fred2u/VMC-Controller/README.md

# VMC Controller

Wi‑Fi remote control for an **Orcon MVS‑15RH** ventilation unit (MVHR/extract fan, "VMC" in French), based on an ESP8266.

The original RF remote (Orcon 15RF) was taken apart: its keypad was replaced by an ESP8266 that "presses" the buttons instead. The ventilation unit can then be controlled from a smartphone (web page on the local network) and from Home Assistant, without touching the unit itself or the radio protocol.

> Personal project, meant for a private local network. The web interface has no password unless one is set at build time (`VMC_HTTP_PASSWORD`), and the traffic is plain HTTP either way: do not expose it to the Internet.

---

## Contents

1. [How it works](#how-it-works)
2. [Hardware](#hardware)
3. [Wiring](#wiring)
4. [Photos of the remote](#photos-of-the-remote)
5. [Final assembly](#final-assembly)
6. [Printed circuit board](#printed-circuit-board)
7. [Software](#software)
8. [Installation](#installation)
9. [Tests](#tests)
10. [Releases](#releases)
11. [Usage](#usage)
12. [HTTP API](#http-api)
13. [Home Assistant integration](#home-assistant-integration) (`rest_command` or MQTT)
14. [How the ventilation unit works](#how-the-ventilation-unit-works)
15. [Troubleshooting](#troubleshooting)
16. [Known limitations](#known-limitations)
17. [Ideas for improvement](#ideas-for-improvement)
18. [License](#license)

---

## How it works

```mermaid
flowchart LR
    phone["📱 Smartphone<br/>web browser"]
    ha["🏠 Home Assistant<br/>rest_command or MQTT"]
    usb["🔌 5 V USB charger"]

    subgraph box["3D-printed enclosure"]
        esp["ESP-Mx DevKit (ESP8285)<br/>web server + LittleFS"]
        remote["Orcon 15RF<br/>remote board<br/>without its keypad"]
    end

    vmc["🌀 Orcon MVS-15RH ventilation unit"]

    phone -- "HTTP, local Wi-Fi" --> esp
    ha -- "HTTP or MQTT, local Wi-Fi" --> esp
    usb -- "5 V" --> esp
    esp -- "6 GPIOs over FFC cable<br/>500 ms pulses" --> remote
    esp -. "3 V instead of the battery" .-> remote
    remote -- "RF radio" --> vmc
```

- The ESP8266 connects to the home Wi‑Fi and serves a small web page. Home Assistant drives it over HTTP (`rest_command`) or, optionally, MQTT.
- Each button on the page matches a button on the remote. The ESP pulls the matching output LOW for 500 ms, which simulates a press.
- The remote board then sends the radio command to the ventilation unit, as if the button had been pressed.
- The ESP powers the remote board from its 3 V output, instead of the battery. The ESP itself is powered by a USB charger.
- Everything fits in a 3D-printed enclosure.

## Hardware

| Item | Details |
|---|---|
| Ventilation unit | Orcon MVS‑15RH (single-flow extract ventilation, 4 positions + auto mode with humidity sensor) |
| Remote | Orcon 15RF, taken apart, keypad removed |
| Microcontroller | DOIT ESP‑Mx DevKit development board (ESP8285, an ESP8266 variant with built-in flash memory), PlatformIO environment `espmxdevkit` |
| Printed circuit board | Home-made 50 × 50 mm PCB that connects the ESP to the FFC breakout (see [Printed circuit board](#printed-circuit-board)) |
| Keypad link | 8-pin, 1.0 mm pitch flexible flat cable (FFC) and FFC breakout, instead of the keypad membrane |
| Power | 5 V USB charger to the ESP, ESP 3 V output to the remote board |
| Enclosure | 3D-printed |

### Bill of materials

Parts used in the build, checked against the [photos](#final-assembly) and the [PCB](#printed-circuit-board). The links are the listings the parts were bought from. Listings change or disappear, so check the specifications below rather than the listing title.

| Qty | Part | Specifications to check | Where to buy |
|---|---|---|---|
| 1 | Orcon 15RF remote | The remote paired with the ventilation unit, opened and keypad membrane removed | Existing remote |
| 1 | ESP8266 development board | DOIT ESP‑Mx DevKit: ESP‑M2 module (ESP8285), CH340 USB chip, micro‑USB, 2 rows of 12 pins, rows 25.4 mm apart. A NodeMCU board (2 rows of 15 pins) does not fit the PCB footprint. | [Amazon](https://www.amazon.fr/dp/B076Q77M1Z) |
| 1 | Flexible flat cable (FFC) | 8 pins, **1.0 mm pitch**, AWM 20624. It goes from the remote's keypad connector to the breakout. Check the length and whether the contacts are on the same side at both ends (type A) or on opposite sides (type B) against your own build. | [AliExpress](https://www.aliexpress.com/item/1005007561337665.html) |
| 1 | FFC breakout | 8-pin FPC adapter board with a **1.0 mm** flip-lock, bottom-contact connector soldered on, and straight 2.54 mm pins. The board silkscreen says `FPC-8P 0.5MM`: that is the unused pad row on the other side, the connector actually soldered is 1.0 mm. | [AliExpress](https://www.aliexpress.com/item/1005012643948143.html) (variant `Straight-8P`) |
| 1 | Home-made PCB | 50 × 50 mm, Gerber files in [`hardware/pcb/gerber/`](hardware/pcb/gerber/) | JLCPCB or another PCB maker |
| 1 | Power cable to the remote | Red and black wires from the ESP 3 V and GND to the battery holder, with a 2-pin detachable connector | Any |
| 1 | USB charger and micro‑USB cable | 5 V, any phone charger | Any |
| 1 | Enclosure | 3D-printed, STL files in [`hardware/enclosure/`](hardware/enclosure/) | 3D printer |

## Wiring

The original keypad is a flexible membrane with a ribbon that plugs into a connector on the remote board (see the [photos](#photos-of-the-remote) and the [final assembly](#final-assembly)). The membrane is removed and replaced by an FFC cable connected to the ESP through a breakout, which avoids soldering on the Orcon board.

Each ESP output is connected to one of the 6 button contacts of the keypad connector. At rest, the outputs are HIGH. A press is a 500 ms LOW state.

| Remote button | Function | Keypad contact | ESP8266 GPIO | Name in the code |
|---|---|---|---|---|
| 1 | Low position | 1 | GPIO2 | `PIN_LOW` |
| 2 | Medium position | 2 | GPIO15 | `PIN_MEDIUM` |
| 3 | High position | 3 | GPIO4 | `PIN_HIGH` |
| House | Default position | 4 | GPIO12 | `PIN_DEFAULT` |
| Auto | Automatic mode | 5 | GPIO5 | `PIN_AUTO` |
| Timer (clock) | Temporary high position | 6 | GPIO14 | `PIN_MAX` |
| Activity LED | On while a command is being sent | | GPIO16 | `PIN_LED` |

The contact numbers match the `// 1` to `// 6` comments in the code, and the 6 button contacts of the remote's keypad connector. On the ESP‑Mx DevKit and on the PCB, pins are labelled directly with their GPIO number (for example `D15` or `15` for GPIO15).

Power:

- 5 V USB charger to the ESP's USB input.
- ESP 3 V output and GND to the remote's battery holder (CR2032).

> GPIO2 and GPIO15 are also used to select the ESP8266 boot mode (GPIO2 must be HIGH and GPIO15 LOW at boot). If the ESP refuses to boot after a wiring change, check these two pins first.

## Photos of the remote

Orcon 15RF remote taken apart, before modification. The photos are in [`docs/photos/`](docs/photos/).

| | |
|---|---|
| Front | Open, with the battery |
| Front: House, Auto, Timer, 1, 2, 3 buttons | Open: CR2032 battery and label (VMN‑15LF01) |
| Keypad and frame | Board in its holder |
| Keypad and wall frame separated | Circuit board in its transparent holder |
| Keypad membrane | Board, component side |
| Keypad membrane: 6 contacts and its ribbon | Board, component side |
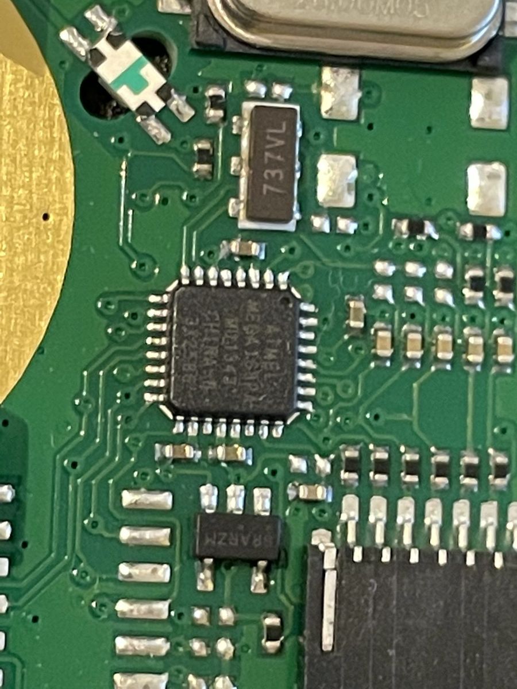
[picture p1: docs/photos/08-board-microcontroller.jpg]
Microcontroller
| Keypad connector |  |
| Keypad ribbon connector (on the left) | Close-up of the microcontroller |
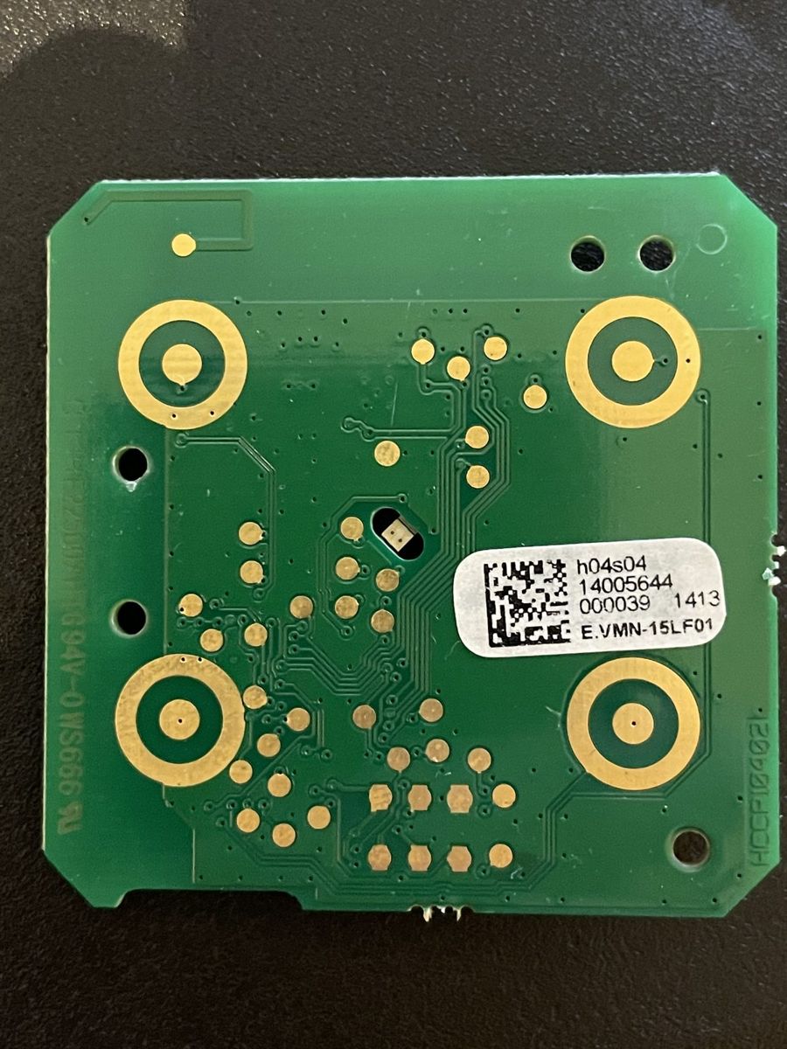
[picture p2: docs/photos/09-board-back.jpg]
Back of the board
|  | Parts of the build |
| Back of the board, contact pads | Parts of the build: ESP boards, FFC cables, 8-pin FFC breakout |

## Final assembly

| | |
|---|---|
| Assembly, open | Assembly in the enclosure |
| Remote board and ESP‑Mx DevKit, mounted on the home-made PCB. The FFC cable links the keypad connector to the 8-pin FFC breakout, and the red and black wires bring the ESP's 3 V to the battery holder, through a detachable connector. | ESP and FFC breakout in the enclosure, micro‑USB socket reachable from the side. |
| Enclosure closed | |
| 3D-printed enclosure, closed and powered over USB. The LED shows through the plastic. | |

### Enclosure files

The enclosure STL files are in [`hardware/enclosure/`](hardware/enclosure/). Dimensions read from the files, in mm:

| File | Dimensions (L × W × H) | Likely part |
|---|---|---|
| [`enclosure-bottom.stl`](hardware/enclosure/enclosure-bottom.stl) | 62 × 62 × 38 | Bottom of the enclosure |
| [`enclosure-lid.stl`](hardware/enclosure/enclosure-lid.stl) | 62 × 62 × 24 | Lid, which fits onto the bottom |
| [`board-plate.stl`](hardware/enclosure/board-plate.stl) | 53 × 53 × 1 | Plate that holds the boards |

GitHub shows a 3D preview of an STL file when you click on it.

## Printed circuit board

A small 50 × 50 mm PCB, designed in EasyEDA (April 2021) and made by JLCPCB, holds the ESP‑Mx DevKit and the FFC breakout. It replaces the loose wiring between the two.

| Top | Bottom (seen from below) |
|---|---|
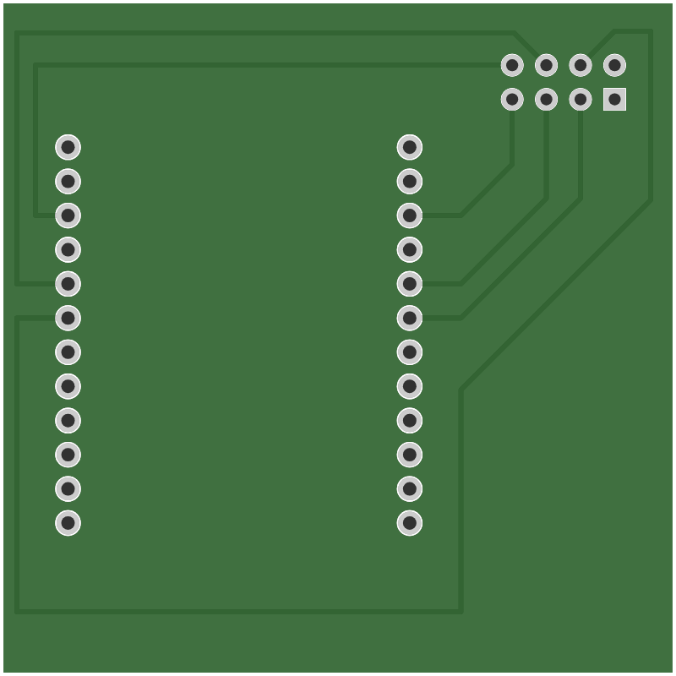
[picture p3: hardware/pcb/pcb-bottom.png]
PCB, bottom side
| PCB, top side |  |

- **Top side**: silkscreen of the ESP‑Mx DevKit footprint (2 rows of 12 pins) and of the `8P` connector (2 × 4 pins) that takes the FFC breakout.
- **Bottom side**: 6 traces connect the `8P` connector to GPIOs 2, 4, 5, 12, 14 and 15, that is the 6 buttons driven by the firmware.
- **Dimensions**: ESP rows 25.4 mm apart, 2.54 mm pitch, 1.0 mm holes for the ESP and 0.889 mm holes for the `8P` connector.

The Gerber files are in [`hardware/pcb/gerber/`](hardware/pcb/gerber/). They can be sent as they are to a manufacturer such as JLCPCB, once zipped.

> The manufactured PCB did not fit perfectly and the parts had to be forced in a little. Before ordering a new batch, measure the actual row spacing of your ESP board and the position of the connector, then fix the footprint if needed.

## Software

| | |
|---|---|
| Environment | [PlatformIO](https://platformio.org/) (VS Code extension recommended in `.vscode/extensions.json`) |
| Framework | Arduino for ESP8266 (`espressif8266`) |
| Web server | [ESPAsyncWebServer](https://github.com/ESP32Async/ESPAsyncWebServer) and [ESPAsyncTCP](https://github.com/ESP32Async/ESPAsyncTCP), maintained by ESP32Async, versions pinned in `platformio.ini` |
| Wi‑Fi setup | [ESPAsyncWiFiManager](https://github.com/alanswx/ESPAsyncWiFiManager) (captive portal on the same async web server) |
| Updates over Wi‑Fi | ArduinoOTA (included in the Arduino core), and an optional web update page |
| MQTT (optional) | [PubSubClient](https://github.com/knolleary/pubsubclient), with Home Assistant discovery |
| File system | LittleFS (web pages stored in flash) |
| Interface | Plain HTML, CSS and JavaScript, no framework (about 20 KB for both pages, light and dark themes) |

Layout:

```
├── platformio.ini       PlatformIO configuration (boards, libraries, LittleFS)
├── src/main.cpp         Firmware: Wi‑Fi, web server, GPIO control, OTA, MQTT
├── scripts/
│   ├── passwords.py     Reads the passwords and the MQTT settings from the VMC_* environment variables
│   ├── ota_auth.py      Gives that password to uploads over Wi‑Fi
│   └── version.py       Builds the version from the Git tags into the firmware
└── data/                Files uploaded to LittleFS
    ├── index.html       Remote control page
    ├── script.js        Sends commands, refreshes the mode, shows the board details
    ├── maintenance.html Maintenance page: pairing, remote reset, restart, Wi‑Fi
    ├── maintenance.js   Sends the maintenance actions, shows the ESP details
    └── style.css        Layout and light/dark themes (both pages)
test/                    Unit tests run on the computer (see Tests), with fake libraries in test/mocks/
docs/                    Photos of the build and screenshots of the interface
hardware/                Enclosure STL files and PCB Gerber files
.github/workflows/ci.yml Tests and firmware builds on GitHub
```

How the firmware works (`src/main.cpp`):

- `setup()` sets up the GPIOs, connects the ESP to Wi‑Fi with the hostname `vmc` (or opens the `VMC-Setup` portal, see [Connect to Wi‑Fi](#5-connect-to-wifi)) and starts the web server. At boot, it sends the **Medium** command, which puts the ventilation unit in a known state.
- HTTP requests only record the requested command. `loop()` presses and releases the buttons step by step with `millis()`, without `delay()`, so the server keeps answering while a command is sent.
- The current mode is remembered by the ESP. It is not read from the ventilation unit, which sends nothing back.

## Installation

### 1. Requirements

- VS Code with the PlatformIO extension, or PlatformIO Core on the command line.
- A USB cable to flash the ESP.

The `pio` commands below go in a **PlatformIO terminal**: in VS Code, open the PlatformIO sidebar, then *Quick Access > Miscellaneous > New Terminal*. A plain PowerShell or terminal window usually does not find `pio`, because the extension does not add it to the PATH. The commands are given for bash (Linux, macOS) and PowerShell (Windows), where they differ.

### 2. Passwords

No password is stored in the project: the Wi‑Fi network is chosen after flashing, from a setup portal (step 5), and the passwords come from environment variables, read at build time by `scripts/passwords.py`:

| Variable | Protects | Without it |
|---|---|---|
| `VMC_OTA_PASSWORD` | Updates over Wi‑Fi with PlatformIO (step 6) | Updates over USB only |
| `VMC_HTTP_PASSWORD` | The web interface and every HTTP route (user `admin`), and turns on the web update page | Open to anyone on the local network, no web update page |
| `VMC_SETUP_PASSWORD` | The `VMC-Setup` access point (at least 8 characters) | Open access point |

Only `VMC_OTA_PASSWORD` is recommended for everyone; the other two are optional. Set them in the terminal before building:

```bash
export VMC_OTA_PASSWORD="choose-a-password"
export VMC_HTTP_PASSWORD="another-password"     # optional
export VMC_SETUP_PASSWORD="setup-password"      # optional, 8 characters or more
```

```powershell
$env:VMC_OTA_PASSWORD = "choose-a-password"
$env:VMC_HTTP_PASSWORD = "another-password"     # optional
$env:VMC_SETUP_PASSWORD = "setup-password"      # optional, 8 characters or more
```

The variables only last as long as the terminal: set them again in each new terminal. On Windows, to keep one for good, run `setx VMC_OTA_PASSWORD "choose-a-password"` once, then open a new terminal (and restart VS Code so that its terminals see it).

With `VMC_HTTP_PASSWORD`, the browser asks for the user `admin` and the password the first time; Home Assistant needs them too (see [Home Assistant integration](#home-assistant-integration)).

Without this variable, the firmware still builds (with a warning) but only accepts updates over USB. Use the same password for every build: the ESP asks for the one it was built with.

> **Coming from an older version**: `include/wifi.h` is no longer read and can be deleted. The ESP keeps the network it was already using (the Wi‑Fi chip saves it in flash). Put the old `OTA_PASSWORD` value in `VMC_OTA_PASSWORD`.

### 3. Build and flash the firmware

Over USB. `-e` picks the board: `espmxdevkit` is the production board inside the VMC, `nodemcuv2` the test board (see [Test board (NodeMCU)](#test-board-nodemcu)). Without `-e`, PlatformIO uses the production board.

```bash
pio run -e espmxdevkit --target upload
```

### 4. Upload the web interface to LittleFS

```bash
pio run -e espmxdevkit --target uploadfs
```

Repeat this step every time a file in the `data/` folder changes.

### 5. Connect to Wi‑Fi

When the ESP has no network saved, or cannot reach it within 30 seconds, it opens its own Wi‑Fi access point named **`VMC-Setup`** (open, or protected by `VMC_SETUP_PASSWORD` if it was set at build time):

1. Connect a phone or a computer to `VMC-Setup`. The setup page usually opens by itself; if not, open `http://192.168.4.1/`.
2. Choose **Configure WiFi**, pick your network in the list and enter its password, then save.
3. The ESP joins the network, saves it in flash and closes the access point. The next boots connect directly.

The portal stays open 3 minutes. Meanwhile, the ESP keeps retrying the saved network every few seconds: after a power cut, when the router takes longer to start than the ESP, it connects as soon as the router is back. If nobody uses the portal, it closes and the ESP keeps retrying the saved network in the background. The ventilation commands only start once the portal has closed. To pick another network later, use **Forget Wi‑Fi** on the [Maintenance page](#usage): the ESP restarts and opens `VMC-Setup`. If the page cannot be reached at all, erase the flash over USB (`pio run --target erase`, then flash and `uploadfs` again).

Check with the serial monitor:

```bash
pio device monitor
```

The serial monitor (115200 baud) shows the list of LittleFS files, the Wi‑Fi manager messages (`*WM:`), then the IP address obtained. The page is then available at `http://vmc/` (if your router resolves hostnames) or `http://<ip-address>/`. It is a good idea to reserve a fixed IP address for the ESP in the router, especially for Home Assistant.

### 6. Updates over Wi‑Fi (OTA)

Once the first flash over USB is done and the ESP is on Wi‑Fi, the next updates can go over the network, without opening the enclosure. The ESP announces itself as `vmc.local` (mDNS) and asks for the password it was built with (`VMC_OTA_PASSWORD`, see step 2):

Each board has a second environment, ending in `_ota`, that always uploads over Wi‑Fi:

```bash
pio run -e espmxdevkit_ota --target upload     # firmware, to vmc.local
pio run -e espmxdevkit_ota --target uploadfs   # web interface
pio run -e nodemcuv2_ota --target upload       # test board, to vmc-test.local
pio run -e nodemcuv2_ota --target uploadfs
```

The commands are the same in PowerShell and in a Linux or macOS terminal. If the `.local` name does not resolve, give another name or the IP address with `--upload-port`, for example the name from your router:

```powershell
pio run -e nodemcuv2_ota --target upload --upload-port vmc-test.lan
pio run -e nodemcuv2_ota --target upload --upload-port 192.168.1.42
```

Keep the `_ota` environment for these. Without it (`-e nodemcuv2`), PlatformIO only switches to Wi‑Fi for an IP address or a name ending in `.local`. Any other name is taken for a serial port, and the upload fails with `could not open port 'vmc-test.lan'`.

With `VMC_OTA_PASSWORD` set, `scripts/ota_auth.py` gives the password to the upload over Wi‑Fi by itself, so there is nothing else to set. Do not put `--auth` in `PLATFORMIO_UPLOAD_FLAGS`: that variable also applies to USB uploads, which then fail with `esptool: error: unrecognized arguments: --auth=...` (in PowerShell, clear it with `Remove-Item Env:PLATFORMIO_UPLOAD_FLAGS`).

The computer must be on the same network, and its firewall must let the ESP connect back to it (espota uses a random TCP port; on Windows, allow Python when the firewall asks).

The production board (ESP‑Mx DevKit) only has 1 MB of flash. An update over Wi‑Fi needs room for the old and the new firmware at the same time, so `platformio.ini` keeps only 64 KB for LittleFS (the web interface is about 20 KB), which leaves about 470 KB for each firmware. The current firmware is about 400 KB, a little over 410 KB with every option (passwords and MQTT). With the default 256 KB for LittleFS, the limit would be about 380 KB and the ESP would refuse the update. The NodeMCU (4 MB) has plenty of room.

#### From the web page, without PlatformIO

With `VMC_HTTP_PASSWORD` (step 2), the Maintenance page also has an **Update** section: choose **Firmware** and `.pio/build/espmxdevkit/firmware.bin`, or **Web interface** and `.pio/build/espmxdevkit/littlefs.bin` (made by `pio run --target buildfs`), then tap **Update**. The ESP restarts when it is done. Without a password, this page is not built in, since anyone on the network could replace the firmware.

> **Coming from v1.0**: the flash layout of the production board changed (LittleFS moved). Flash it once over USB, firmware **and** web interface (`upload` then `uploadfs`); the next updates can go over Wi‑Fi.

## Tests

Unit tests check the firmware on the computer, without an ESP or a remote:

```bash
pio test -e native
```

The tests are built by the computer's own C++ compiler, not the ESP one. Linux and macOS usually have it already (`g++` or `clang`). On Windows, install a MinGW-w64 `gcc`/`g++`, for example [WinLibs](https://winlibs.com/), add its `bin` folder to the PATH, then open a new PlatformIO terminal: `g++ --version` must answer.

`src/main.cpp` is compiled **as is**: the tests only replace the Arduino, Wi‑Fi, Wi‑Fi manager, LittleFS, web server, OTA, update and MQTT libraries with fakes (folder `test/mocks/`). These fakes record every pin change and every pause, which makes it possible to check, for example:

- that at boot all pins are outputs and released, then that Medium is sent;
- that each URL presses the right button, with a 500 ms pulse and the LED on while sending, and answers the mode it sets;
- that `loop()` never calls `delay()`, so the web server keeps answering while a command is sent, and that a command received meanwhile is sent after it (only the last one if several arrive);
- that Max 15/30/60 min presses Timer 1, 2 or 3 times, 600 ms apart, then that `/mode` goes back to the previous mode when the time is up, also when `millis()` wraps around after 49 days;
- that Max commands are refused with `409` in High mode;
- that `/pair` holds `1` and `Auto` together for 5 s and `/reset-remote` holds `Default` and `Timer` for 4 s, without changing the mode, that they and `/restart` and `/forget-wifi` only answer `POST`, that a restart waits for the answer and never cuts a press short, and that the uptime survives the `millis()` wraparound;
- that pages are served from LittleFS, that `/version` answers the built-in version, that `/info` answers the version, name, IP address and Wi‑Fi signal as JSON, and that an unknown URL answers `404`;
- that the Wi‑Fi manager opens `VMC-Setup` with its timeouts, that no network is compiled into the firmware, that the web routes are added after the portal, and that without Wi‑Fi the ESP keeps retrying and still sends Medium;
- that with a password every route answers `401` without it or with a wrong one, that the `VMC-Setup` access point gets its password, and that the web update writes the firmware or the web interface (unmounting LittleFS first), refuses a request without the password, answers `500` on a failed update, then restarts;
- that MQTT connects once Wi‑Fi is up with its user, password and last will, announces the buttons and the mode sensor to Home Assistant, publishes the mode when it changes, runs the commands it receives (not the maintenance ones), and retries every 30 s without blocking the commands;
- that OTA only starts once Wi‑Fi is connected, with the `vmc` name and the password, and that it unmounts LittleFS before a web interface update.

The tests also run automatically on GitHub (*Actions* tab) on every push and pull request, together with a firmware build for both ESP boards (production and test).

### Test board (NodeMCU)

To try changes without touching the VMC, the same firmware can run on a spare **NodeMCU v3** board (LoLin, ESP‑12 module with 4 MB flash, CH340 USB chip). The code is unchanged; only the PlatformIO environment differs:

```bash
pio run -e nodemcuv2 --target upload     # firmware
pio run -e nodemcuv2 --target uploadfs   # web interface (data/)
pio device monitor
```

`pio run` without `-e` still builds the production board (`espmxdevkit`) only.

The test board uses its own network name, `vmc-test` (`http://vmc-test/`, `vmc-test.local` for OTA with `-e nodemcuv2_ota`), set by `build_flags` in `platformio.ini`. Both boards can then be on the same Wi‑Fi at the same time: with the same name, the router hands `vmc` to whichever board connected last, and `http://vmc/` and Home Assistant lose the production board. If a test build ever went out with the name `vmc`, remove the old `vmc` entry for the NodeMCU in the router, and restart the production ESP so that it registers its name again.

A NodeMCU labels its pins `D0`…`D8` instead of GPIO numbers:

| Button | GPIO | NodeMCU pin | Notes |
|---|---|---|---|
| 1 (`PIN_LOW`) | GPIO2 | `D4` | Boot pin, must be HIGH at boot. Also drives the blue LED of the ESP‑12 module, which lights up on each Low press. |
| 2 (`PIN_MEDIUM`) | GPIO15 | `D8` | Boot pin, must be LOW at boot (10 kΩ pull-down on the board). |
| 3 (`PIN_HIGH`) | GPIO4 | `D2` | |
| House (`PIN_DEFAULT`) | GPIO12 | `D6` | |
| Auto (`PIN_AUTO`) | GPIO5 | `D1` | |
| Timer (`PIN_MAX`) | GPIO14 | `D5` | |
| Activity LED (`PIN_LED`) | GPIO16 | `D0` | Also drives the board's red LED, which lights up during every command. |

None of these pins is used by the flash memory or the USB serial link, and the boot pins are only driven after boot, so the NodeMCU starts normally with nothing connected.

**Testing without the remote**: with nothing wired, the board's two LEDs and the serial monitor (which prints each command received) are already enough to check the web interface and Home Assistant. To see every button, wire one LED per output, with a 330 Ω to 1 kΩ resistor:

- `D1`, `D2`, `D4`, `D5`, `D6`: from `3V3` through the resistor and the LED to the pin (cathode on the pin side). The LED lights up during the 500 ms press, like the remote button.
- `D8` (GPIO15): wire it the other way, from the pin through the resistor and the LED to `GND`. An LED pulled up to `3V3` could hold GPIO15 HIGH at boot and stop the board from starting. This LED is lit at rest and goes off during a Medium press.

## Releases

Each firmware knows its version, taken from the Git tags when it is built (`scripts/version.py`, which runs `git describe --tags --always --dirty`). The ESP prints it on the serial port at boot, answers it on `/version` and `/info`, and the web interface shows it at the bottom of the page.

| Version shown | Meaning |
|---|---|
| `v1.1` | Built exactly on the `v1.1` tag: a release |
| `v1.1-3-g1a2b3c4` | 3 commits after `v1.1`, at commit `1a2b3c4` (work in progress) |
| `v1.1-3-g1a2b3c4-dirty` | Same, with changes not committed yet |
| `unknown` | Git was not found, or the project was not cloned with Git (ZIP download) |

The PlatformIO build log shows it too: `VMC Controller firmware version: v1.1`.

To publish a version:

1. Merge the changes into `main`, then test them on the test board.
2. On GitHub: **Releases** › **Draft a new release** › **Choose a tag**, type the new number (for example `v1.1`), target `main`, then **Publish release**. Or from a terminal (PowerShell works the same):

   ```bash
   git checkout main
   git pull
   git tag -a v1.1 -m "v1.1"
   git push origin v1.1
   ```

3. Get the tag on the computer (`git pull --tags`), then build and flash: the ESP now shows `v1.1`.

Each version is described in [CHANGELOG.md](CHANGELOG.md): add its section before tagging. Numbers follow `vMAJOR.MINOR`: increase `MINOR` for a new feature or a fix, and `MAJOR` for a change that needs a USB flash or a new wiring. The web interface (LittleFS) has no version of its own: upload it again (`uploadfs`) with each release.

## Usage

| | | | |
|---|---|---|---|
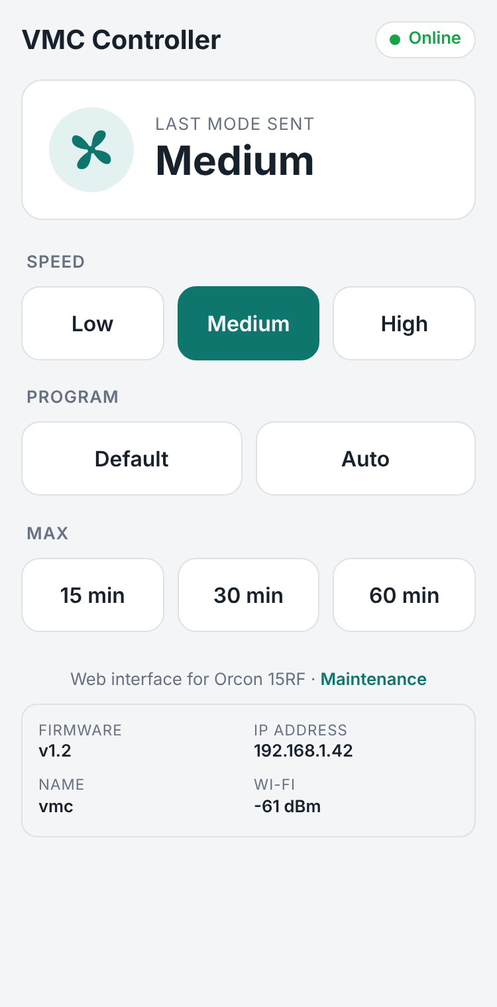
[picture p4: docs/screenshots/mobile-medium.png]
Interface on a smartphone, Medium mode
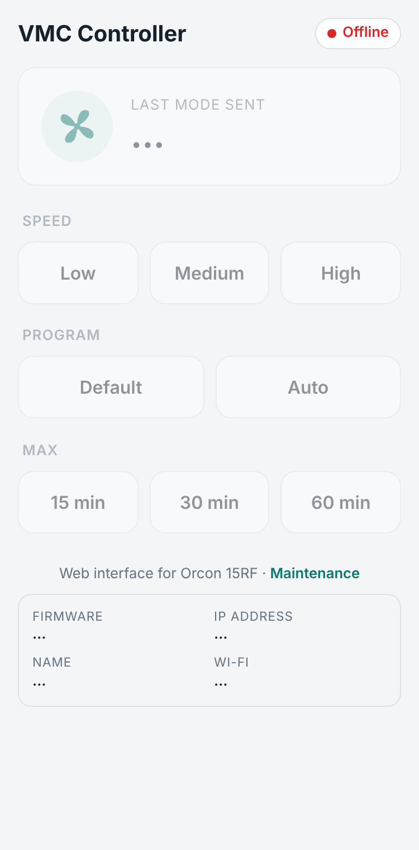
[picture p5: docs/screenshots/mobile-offline.png]
Interface on a smartphone, ESP unreachable
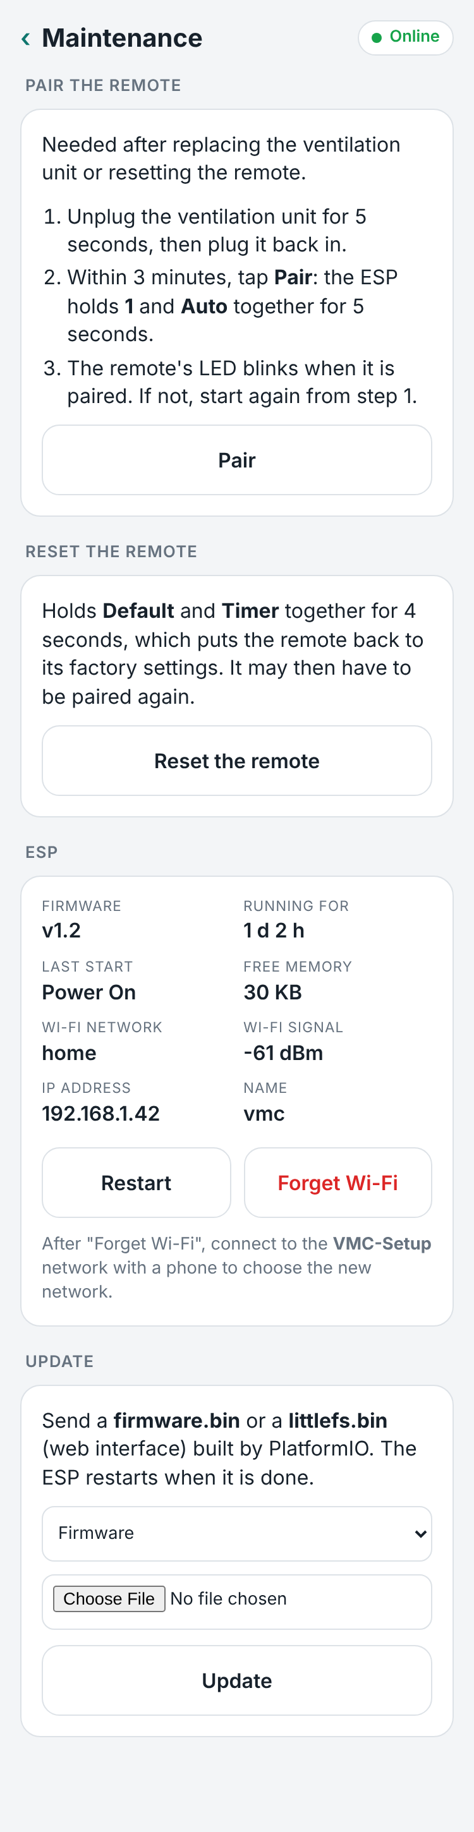
[picture p6: docs/screenshots/mobile-maintenance.png]
Maintenance page
|  | Interface on a smartphone in dark theme, Max 30 min mode |  |  |
| At boot, the ESP sends Medium | After pressing "Max 30 min" (dark theme) | ESP unreachable | Maintenance page |

The page follows the phone's light or dark theme. It shows:

- the last mode sent, refreshed every 2 seconds, with the matching button highlighted and a fan that turns faster with the speed;
- an **Online** / **Offline** badge: after two refreshes without an answer (3 s each), the page says **Offline** and greys out the buttons, then comes back on its own;
- the eight buttons below, grouped by Speed, Program and Max. The Max buttons are greyed out while in High, since the firmware refuses them there;
- at the bottom, the firmware version, the IP address, the network name and the Wi‑Fi signal of the ESP (from `/info`), and a link to the **Maintenance** page.

The **Maintenance** page (`http://vmc/maintenance`) gathers what is rarely needed:

- **Pair the remote** with the ventilation unit, with the procedure: unplug the unit for 5 seconds, plug it back in, then tap **Pair** within 3 minutes. The ESP holds `1` and `Auto` together for 5 seconds; the remote's LED blinks once it is paired.
- **Reset the remote** to its factory settings: the ESP holds `Default` and `Timer` together for 4 seconds.
- The ESP details: firmware, time since the last start and its reason, free memory, Wi‑Fi network and signal, IP address and name.
- **Restart** the ESP, and **Forget Wi‑Fi**: the ESP erases the saved network and restarts in setup mode (`VMC-Setup` access point, see [Connect to Wi‑Fi](#5-connect-to-wifi)), for example after changing the Internet box.

Each action asks for confirmation first.

| Button | Effect on the ventilation unit |
|---|---|
| Default | Default position, very low consumption, ignores the sensors |
| Auto | Auto mode, driven by the built-in humidity sensor |
| Low | Position 1 (low) |
| Medium | Position 2 (medium) |
| High | Position 3 (high) |
| Max 15 min | Position 3 for 15 min, then back to the previous position |
| Max 30 min | Position 3 for 30 min, then back to the previous position |
| Max 60 min | Position 3 for 60 min, then back to the previous position |

The "Max" modes match the remote's Timer button, pressed 1, 2 or 3 times. They are refused (HTTP `409`) if the current mode is already High, where the Timer button does nothing.

## HTTP API

The routes are on port 80. With `VMC_HTTP_PASSWORD`, every route asks for the user `admin` and that password (HTTP Basic or Digest), and answers `401` without them: `curl -u admin:password http://vmc/low`. The mode buttons and the information routes answer `GET` (as `rest_command` sends by default). The maintenance actions only answer `POST`, so that opening their link by mistake does nothing (`GET` answers `404`).

| Route | Response | Purpose |
|---|---|---|
| `/` or `/index.html` | HTML page | Web interface |
| `/default` | `200`, `text/plain`: `Default` | Default position |
| `/auto` | `200`, `text/plain`: `Auto` | Automatic mode |
| `/low` | `200`, `text/plain`: `Low` | Low position |
| `/medium` | `200`, `text/plain`: `Medium` | Medium position |
| `/high` | `200`, `text/plain`: `High` | High position |
| `/max1` | `200`, `text/plain`: `Max 15 min` | High position for 15 min |
| `/max2` | `200`, `text/plain`: `Max 30 min` | High position for 30 min |
| `/max3` | `200`, `text/plain`: `Max 60 min` | High position for 60 min |
| `/mode` | `text/plain` | Current mode: `Default`, `Auto`, `Low`, `Medium`, `High`, `Max 15 min`, `Max 30 min` or `Max 60 min` |
| `/pair` | `POST`, `200`, `text/plain`: `Pairing` | Holds `1` and `Auto` together for 5 s, to pair the remote |
| `/reset-remote` | `POST`, `200`, `text/plain`: `Remote reset` | Holds `Default` and `Timer` together for 4 s, to reset the remote |
| `/restart` | `POST`, `200` | Restarts the ESP about a second later |
| `/forget-wifi` | `POST`, `200` | Erases the saved Wi‑Fi network, then restarts in setup mode (`VMC-Setup`) |
| `/maintenance` | HTML page | Maintenance page |
| `/update/firmware`, `/update/web` | `POST` (file upload), `200` or `500` | Web update of the firmware or of the web interface, then restart. Only with `VMC_HTTP_PASSWORD` |
| `/version` | `text/plain` | Firmware version, for example `v1.1` (see [Releases](#releases)) |
| `/info` | `application/json` | Board details: `{"version":"v1.2","hostname":"vmc","ip":"192.168.1.42","rssi":-61,"ssid":"home","uptime":3600,"heap":31000,"reset":"Power On","update":true}` (`rssi` is the Wi‑Fi signal in dBm: around -50 is very good, below -80 is weak; `uptime` is in seconds since the last start, `heap` the free memory in bytes, `reset` the reason of the last start, `update` whether the web update page is built in) |

A command answers right away with the mode it sets, and the ESP presses the button just after. A Max command in High mode answers `409` with `Max is ignored in High mode` and presses nothing. A command received while another one is being sent (up to about 3 seconds for Max 60 min) waits for it to finish; if several arrive meanwhile, only the last one is sent. Example:

```bash
curl http://vmc/high      # -> High
curl http://vmc/max1      # -> Max is ignored in High mode (409)
curl http://vmc/mode      # -> High
curl http://vmc/version   # -> v1.1
curl http://vmc/info      # -> {"version":"v1.2","hostname":"vmc",...,"uptime":3600,...}
curl -X POST http://vmc/pair   # -> Pairing
```

## Home Assistant integration

Home Assistant controls the ventilation unit with `rest_command`, and can read the mode with a `rest` sensor. Example configuration (`configuration.yaml`):

```yaml
rest_command:
  vmc_default: { url: "http://vmc/default" }
  vmc_auto:    { url: "http://vmc/auto" }
  vmc_low:     { url: "http://vmc/low" }
  vmc_medium:  { url: "http://vmc/medium" }
  vmc_high:    { url: "http://vmc/high" }
  vmc_max15:   { url: "http://vmc/max1" }
  vmc_max30:   { url: "http://vmc/max2" }
  vmc_max60:   { url: "http://vmc/max3" }

sensor:
  - platform: rest
    name: VMC mode
    resource: http://vmc/mode
    scan_interval: 30
```

Replace `vmc` with the ESP's IP address if your network does not resolve the hostname. With `VMC_HTTP_PASSWORD`, add the user and password to each command and to the sensor, for example `vmc_low: { url: "http://vmc/low", username: admin, password: !secret vmc_password }`, and `username`/`password` under the `rest` sensor. The commands can then be called from dashboard buttons or automations, for example "Max 30 min" when the bathroom humidity goes above a threshold.

### MQTT and Home Assistant discovery

Instead of `rest_command`, the ESP can talk to an MQTT broker (for example the Mosquitto add-on of Home Assistant). Home Assistant then finds a device named after the ESP (`vmc`) by itself, with one button per command and a **Mode** sensor, updated as soon as the mode changes, without polling.

MQTT is built in only when the broker is given at build time (step 2 of the installation):

```bash
export VMC_MQTT_HOST="192.168.1.10"       # or the broker's name
export VMC_MQTT_USER="vmc"                # if the broker asks for a user
export VMC_MQTT_PASSWORD="mqtt-password"
# export VMC_MQTT_PORT="1883"             # 1883 by default
```

```powershell
$env:VMC_MQTT_HOST = "192.168.1.10"
$env:VMC_MQTT_USER = "vmc"
$env:VMC_MQTT_PASSWORD = "mqtt-password"
```

Topics, prefixed with the ESP's network name (`vmc`, or `vmc-test` for the test board):

| Topic | Direction | Content |
|---|---|---|
| `vmc/command` | to the ESP | `default`, `auto`, `low`, `medium`, `high`, `max1`, `max2` or `max3` (same as the HTTP routes; Max in High is ignored) |
| `vmc/mode` | from the ESP, retained | Last mode sent, as on `/mode` |
| `vmc/status` | from the ESP, retained | `online`, or `offline` when the ESP disappears (last will) |
| `homeassistant/button/vmc/<command>/config`, `homeassistant/sensor/vmc/mode/config` | from the ESP, retained | Home Assistant discovery |

If the broker does not answer, the ESP tries again every 30 seconds; the web interface and the HTTP routes keep working. Pairing and remote reset stay on the Maintenance page. The HTTP routes and `rest_command` still work alongside MQTT.

## How the ventilation unit works

Summary of the Orcon MVS‑15RH manual, useful to understand the commands:

- **4 positions**: default, low (1), medium (2), high (3). The airflow of each position is set with the DIP switches on the unit's board (curve tables A and B in the installer manual).
- **Auto mode**: the unit measures humidity continuously. If it rises by more than 5 to 10 % in 3 minutes, the unit switches to position 2 or 3, then goes back to auto after 15 or 30 minutes depending on DIP switch 8.
- **Timer**: 1, 2 or 3 presses give the high position for 15, 30 or 60 minutes, then the unit goes back to the last position chosen. Pressing another button stops the timer.
- **After a power cut**, the unit restarts in automatic mode.
- **Pairing a remote**: unplug the unit for 5 seconds, plug it back in, then within 3 minutes press `1` and `Auto` on the remote at the same time until its LED blinks. With this build, use **Pair** on the Maintenance page, which holds both buttons for 5 seconds.
- **Resetting the remote**: press Default and Timer together for 3 seconds (**Reset the remote** on the Maintenance page).

## Troubleshooting

Start with the serial monitor (`pio device monitor`, 115200 baud, ESP connected over USB). At boot it lists the LittleFS files, then prints `Connection established` and the IP address. Each command received is printed too.

| Symptom | What to check |
|---|---|
| The page at `http://vmc/` does not open | Try `http://<ip-address>/` with the address from the serial monitor: some routers do not resolve the `vmc` hostname. If it opens on the test board instead, that board was built with the name `vmc`: see [Test board](#test-board-nodemcu). |
| `Connection established` never shows | The Wi‑Fi network or password has changed (new Internet box, for example). Restart the ESP: it cannot reach the old network, so it opens the `VMC-Setup` portal for 3 minutes, see [Connect to Wi‑Fi](#5-connect-to-wifi). |
| The `VMC-Setup` access point does not show | The ESP reached its saved network, or the 3 minutes are over: restart it. To force the portal while the old network still works, use **Forget Wi‑Fi** on the Maintenance page. |
| The page is blank or returns an error, but `/mode` answers | The LittleFS file list is empty in the serial monitor: upload the interface with `pio run -e espmxdevkit --target uploadfs`. |
| An upload over Wi‑Fi fails with `could not open port '...'` | PlatformIO took the name for a serial port. Use the `_ota` environment (`-e nodemcuv2_ota` or `-e espmxdevkit_ota`), see [Updates over Wi‑Fi](#6-updates-over-wifi-ota). |
| The ESP does not start after a wiring change | Check GPIO2 (must be HIGH at boot) and GPIO15 (must be LOW at boot), see [Wiring](#wiring). |
| The ESP LED (GPIO16) lights up during a command, but the ventilation unit does not react | Check the FFC cable and breakout, and the 3 V power to the remote's battery holder. If the remote board is powered and connected, it may no longer be paired (after replacing or resetting the unit, for example): pair it again, see [How the ventilation unit works](#how-the-ventilation-unit-works). |
| The mode shown does not match the ventilation unit | Expected: the ESP only knows the last mode it sent, see [Known limitations](#known-limitations). |

## Known limitations

- **Optional authentication**: without `VMC_HTTP_PASSWORD`, anyone on the local network can control the ventilation unit. With it, the password is checked but the traffic is plain HTTP (no encryption).
- **Estimated mode**: the mode shown is the one from the last command sent by the ESP. A command sent by another remote, a return to auto mode after a power cut, or a timer ending on the unit side are not seen by the ESP.
- **Max mode duration**: the ESP counts the Max duration from the moment it sends the command, with `millis()`. The unit has its own timer, so the two can drift by a few seconds.
- **Updates over Wi‑Fi**: protected by a password, but sent unencrypted over the local network.
- **Setup portal**: the `VMC-Setup` access point has no password unless `VMC_SETUP_PASSWORD` is set. It only opens when the ESP cannot reach its network, for 3 minutes after a boot. To choose another network, use **Forget Wi‑Fi** on the Maintenance page. If the ESP can no longer be reached at all, a hardware button is still missing (see the factory reset idea in the [roadmap](ROADMAP.md)).

## Ideas for improvement

What the project is still missing (a reset button on the enclosure, a more compact PCB, a circuit diagram…) is detailed in the [roadmap](ROADMAP.md). What changed in each version is in the [changelog](CHANGELOG.md).

## License

This project (code, enclosure and PCB files) is released under the [MIT](LICENSE) license.
