fred2u/VMC-Controller/ROADMAP.md

# Roadmap

The VMC Controller works every day, but it is still a **prototype**. This document lists what is missing to turn it into a more polished version that is easy to reproduce and maintain. It is the starting point for a possible version 2, as the current version is not meant to change.

Items are grouped by topic. The priority shows how much it matters to someone reproducing the project.

| Priority | Meaning |
|---|---|
| 🔴 High | Missing piece that gets in the way during installation or when something breaks |
| 🟠 Medium | Clear improvement in comfort or reliability |
| 🟢 Low | Finishing touch |
| ✅ | Done |

---

## 1. Remote features

### ✅ Remote pairing mode

**Today**: to pair the remote with the ventilation unit (after replacing the unit or after a reset, for example), `1` and `Auto` must be pressed **at the same time**. The firmware only sends one press at a time, so the enclosure has to be opened and the contacts bridged by hand.

**To do**:

- Add a `/pair` route (and a button in the interface, possibly tucked away in a "Maintenance" page) that pulls GPIO2 (`1`) and GPIO5 (`Auto`) LOW at the same time, until the remote's LED blinks. The exact duration has to be found by trial: the manual only says "until the LED blinks".
- Show the procedure on the ventilation unit side in the interface: unplug the unit for 5 seconds, plug it back in, then start pairing within 3 minutes.
- In the same way, add the **remote reset** (`Default` and `Timer` pressed together for 3 seconds).
- Make `sendCommand` able to press several buttons at once and to hold the press longer, which both features need.

✅ Done: the **Maintenance** page (`/maintenance`) has **Pair** (`POST /pair`, `1` and `Auto` held for 5 s) with the procedure, and **Reset the remote** (`POST /reset-remote`, `Default` and `Timer` held for 4 s). Each command in the firmware table can press two buttons and has its own hold time. The 5 s for pairing is a first guess: adjust `pair_delay` in `src/main.cpp` if the LED does not blink.

### ✅ Feedback on the Max modes

- ✅ ~~Max commands are silently ignored when the current mode is High.~~ They are refused with `409` and `Max is ignored in High mode` (the Timer button does nothing in High), and the interface greys out the Max buttons in High.
- ✅ ~~The command routes answer `200` before running the command.~~ They answer the mode the command sets, as `text/plain` (for example `Max 30 min`). The URLs are unchanged, so Home Assistant's `rest_command` keeps working.

---

## 2. Hardware

### 🔴 Factory reset button on the enclosure

**Today**: no button can be reached with the enclosure closed. After changing the Internet box or the Wi‑Fi password, the enclosure has to be opened and the ESP reflashed.

**To do**:

- Add a button that can be reached from outside, recessed or pressed with a paperclip to avoid accidental presses. It can be wired to a free pin (GPIO13 for example) or to the board's `FLASH` button (GPIO0).
- Suggested behaviour:
  - short press: restart;
  - long press (about 10 seconds): erase the saved Wi‑Fi settings and go back to setup mode (see the Wi‑Fi section below);
  - possibly, reset the remote (see above).
- Show each step with the LED (fast blinking during the long press, for example).
- Make room for the button in the 3D-printed enclosure.

### 🟠 More compact version

**Today**: the build is a prototype, with an ESP‑Mx DevKit development board, an FFC breakout, a ribbon cable and a home-made 50 × 50 mm PCB that did not fit perfectly. It all fits in an enclosure of about 62 × 62 × 42 mm.

**Ideas for a version 2**:

- **A single PCB** that directly carries:
  - a bare ESP module (ESP‑12F or ESP8285) instead of the development board;
  - an 8-pin 1.0 mm pitch FPC connector soldered on the board, to plug in the remote's ribbon without a breakout;
  - a USB socket (preferably USB‑C) and a 3.3 V regulator;
  - the reset button and a status LED.
- **Stacking**: put the remote board on top of the new PCB, or the other way round, rather than side by side.
- **Footprints to check** before ordering: measure the real dimensions of the parts (row spacing, connector positions) and print the PCB at 1:1 scale on paper to check the fit.
- **Programming**: add a serial header (RX, TX, GND, GPIO0, RST) for the first flash, then switch to OTA.
- **Enclosure**: redesign it around the new PCB and publish the source file (STEP or Fusion 360) along with the STLs, so it can be modified.

### 🟢 Boot pins

GPIO2 and GPIO15 are also used to select the ESP8266 boot mode. If the remote's circuit pulls one of these pins the wrong way at boot, the ESP does not start. On a new board, prefer pins with no boot role (GPIO4, 5, 12, 13, 14), or check this point.

---

## 3. Software

### ✅ Wi‑Fi setup with a library

~~The network name and password were hard-coded in `include/wifi.h`.~~ [ESPAsyncWiFiManager](https://github.com/alanswx/ESPAsyncWiFiManager) is in place: when the ESP cannot reach a saved network, it opens the `VMC-Setup` access point with a captive portal for 3 minutes, see "Connect to Wi‑Fi" in the README. `include/wifi.h` is gone: the OTA password comes from the `VMC_OTA_PASSWORD` environment variable at build time.

Still to do:

- Erase the saved network with the factory reset button (see "Factory reset" above). ✅ From the maintenance page: **Forget Wi‑Fi**.
- ✅ ~~Optionally protect the `VMC-Setup` access point with a password.~~ `VMC_SETUP_PASSWORD` at build time.

### ✅ Updates over Wi‑Fi (OTA)

~~Add ArduinoOTA or a web update page (`/update`), to update the firmware and the interface without opening the enclosure or plugging in a cable.~~ ArduinoOTA is in place, protected by a password (`VMC_OTA_PASSWORD`), see the README. ✅ A web update (Maintenance page, `/update/firmware` and `/update/web`) updates without PlatformIO, when the firmware is built with `VMC_HTTP_PASSWORD`.

### ✅ Native Home Assistant integration

Today, the integration goes through a manual `rest_command` configuration. An MQTT integration with Home Assistant auto-discovery would directly create a "VMC" device with its buttons and a mode sensor. It would also give the state without polling `/mode` over and over.

✅ Done, optional: built with `VMC_MQTT_HOST`, the ESP connects to the broker and announces a device with one button per command and a mode sensor (MQTT discovery), see "MQTT and Home Assistant discovery" in the README.

### ✅ Command reliability

- ✅ ~~**Lost commands**: a command received while another one is being sent is lost.~~ It waits for the current command to finish. Only the last one counts: a newer command replaces the one still waiting, rather than queueing them all.
- ✅ ~~**Shared variables**: the current command is a `String` written by the async server and read by `loop()`.~~ The commands are a table, and the web server and `loop()` share small `volatile` numbers.
- ✅ ~~**Blocking delays**: `loop()` uses `delay()` while sending the pulses.~~ A state machine based on `millis()` presses and releases the buttons, so the web server and OTA keep answering while a command is sent.
- ✅ ~~**Max mode duration**: the end of the Max mode is computed with `time(0)`.~~ It uses `millis()`, and survives its wraparound after 49 days.

### 🟢 Displayed state

The mode shown is the one from the last command sent by the ESP, and it is not read from the ventilation unit. A command sent by another remote, or the return to auto mode after a power cut, are not seen. This is a limit of the build, since the remote receives nothing. It should at least be stated in the interface ("last mode sent").

✅ The interface now shows "Last mode sent" instead of "Current mode". The limitation itself remains.

### ✅ Security

✅ Optional authentication: with `VMC_HTTP_PASSWORD` at build time, every route asks for the user `admin` and that password (Basic or Digest), which Home Assistant's `rest_command` supports. The traffic stays plain HTTP.

~~There is no authentication. That is acceptable on a trusted local network, but there should at least be optional HTTP basic authentication, especially if OTA is added, since OTA would allow the firmware to be replaced.~~

---

## 4. Web interface

- ✅ ~~Use one language: the buttons are in English ("Low", "Medium", "High"), except "Automatique", and the page is declared as French.~~ Everything is in English: "Automatique" becomes "Auto" (also in the `/mode` response) and the page is declared as English.
- ✅ ~~Highlight the active mode on its button, in addition to the "Current mode" text.~~ The active mode's button is filled.
- ✅ ~~Fix a typo in `data/style.css`: `margin: 0 10px O O;` uses the letter `O` instead of the digit `0`, which makes the rule invalid.~~ Replaced with `margin: 0 10px;`.
- ✅ Show the mode as soon as the page opens, without waiting for the first 2-second refresh.
- ✅ Fix the `<meta>` tag in `index.html`, where `charset` was stuck to the `viewport` attribute and therefore ignored.
- ✅ Redesign the page for smartphones without a CSS framework (Milligram removed): light and dark themes, buttons grouped by Speed, Program and Max, Online/Offline badge when the ESP stops answering.
- ✅ Show the system information at the bottom of the page: version, IP address, network name and Wi‑Fi signal, from the new `/info` route (JSON).
- ✅ Add a "Maintenance" page: pairing, remote reset, uptime, last restart reason, free memory, Wi‑Fi network, restart and Forget Wi‑Fi.

---

## 5. Project and documentation

- 🟠 Add a circuit diagram, for example exported from EasyEDA, in addition to the PCB.
- ✅ ~~Add an automatic build check (GitHub Actions with PlatformIO), to make sure the firmware still builds with recent library versions.~~ Done along with the unit tests (`.github/workflows/ci.yml`).
- ✅ ~~Pin the ESP Async WebServer library version in `platformio.ini`. Without a version, a library update can break the build.~~ Done: the libraries now come from the maintained ESP32Async forks, pinned to a release, and the `espressif8266` platform is pinned too.
- ✅ ~~Number the firmware versions (Git tags) and show the version in the interface.~~ The version comes from `git describe` at build time, is answered on `/version` and shown at the bottom of the page, see "Releases" in the README.
