fred2u/VMC-Controller/docs/photos/01-telecommande-face.jpg

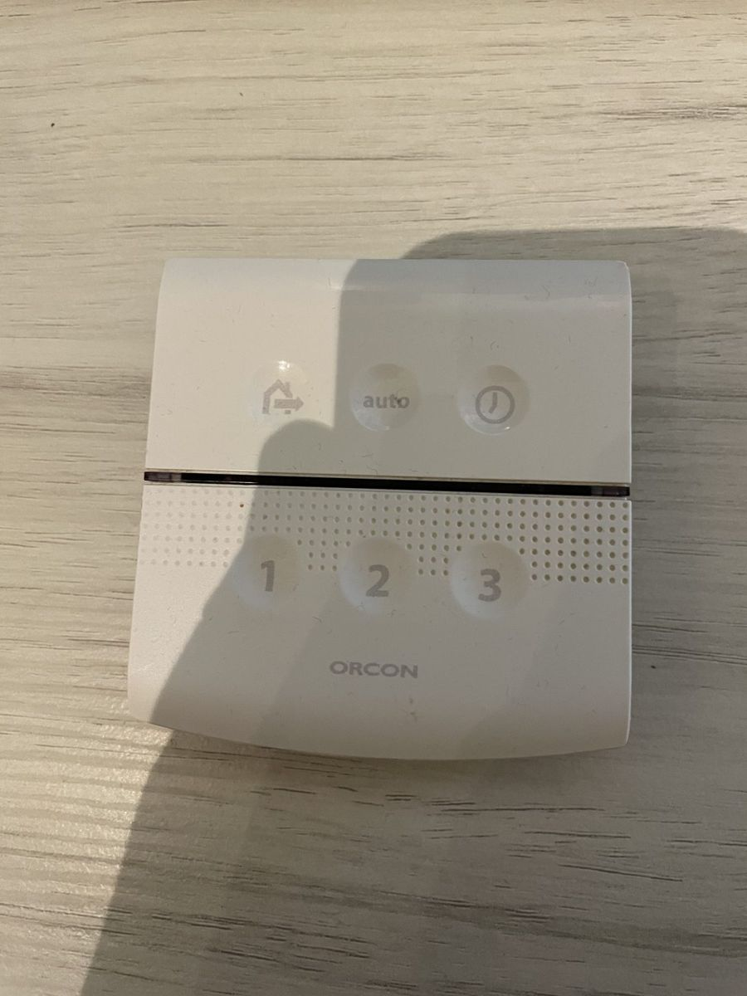
docs/photos/01-telecommande-face.jpg
