fred2u/VMC-Controller/docs/photos/02-telecommande-ouverte-pile.jpg

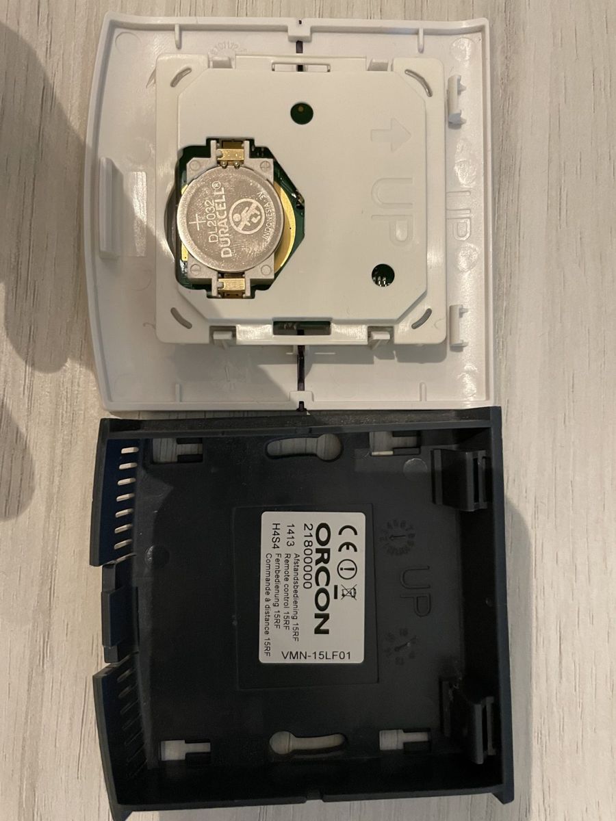
docs/photos/02-telecommande-ouverte-pile.jpg
