fred2u/VMC-Controller/docs/photos/03-clavier-et-cadre.jpg

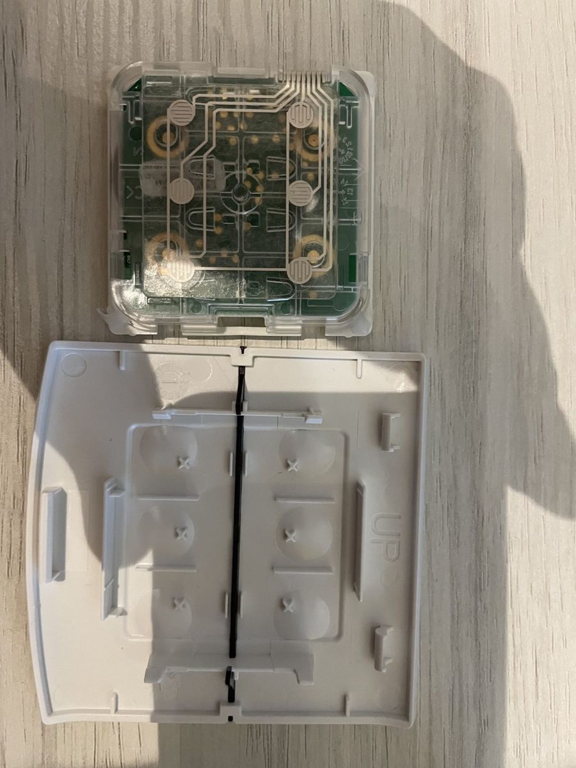
docs/photos/03-clavier-et-cadre.jpg
