fred2u/VMC-Controller/docs/photos/07-carte-connecteur-clavier.jpg

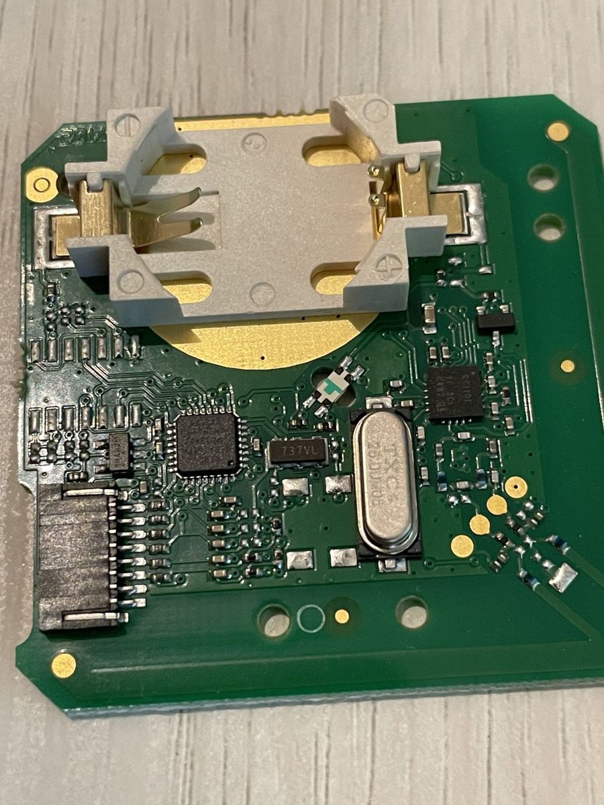
docs/photos/07-carte-connecteur-clavier.jpg
