fred2u/VMC-Controller/docs/photos/10-composants-esp-nappes.jpg

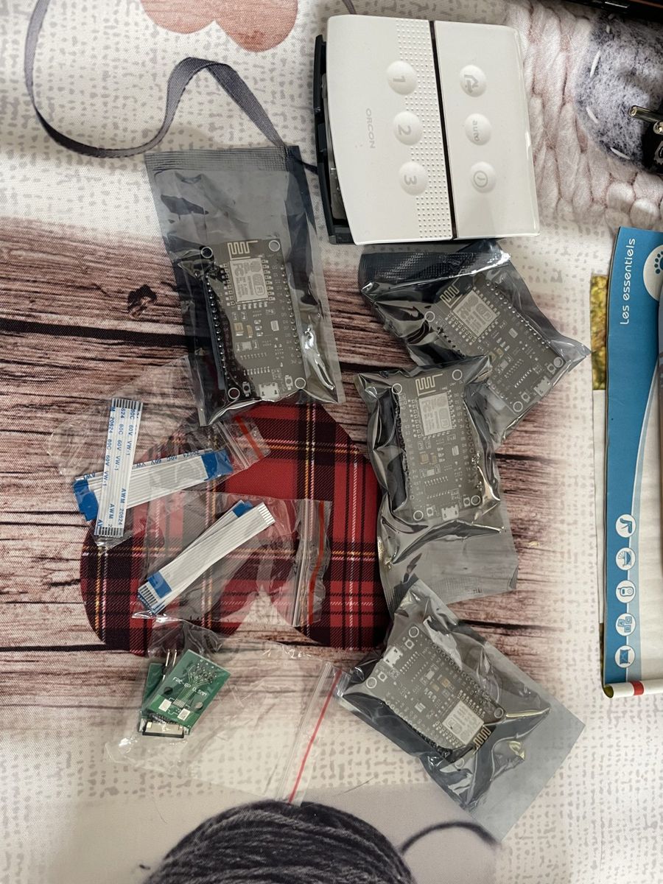
docs/photos/10-composants-esp-nappes.jpg
