fred2u/VMC-Controller/docs/screenshots/mobile-max30.png

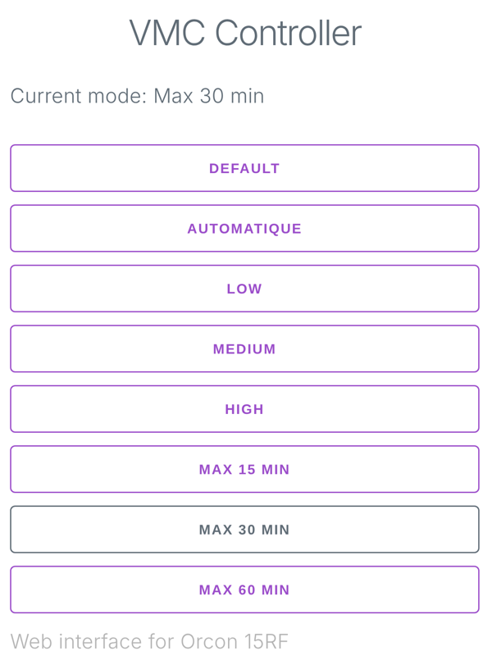
docs/screenshots/mobile-max30.png
