fred2u/VMC-Controller/hardware/enclosure/board-plate.stl

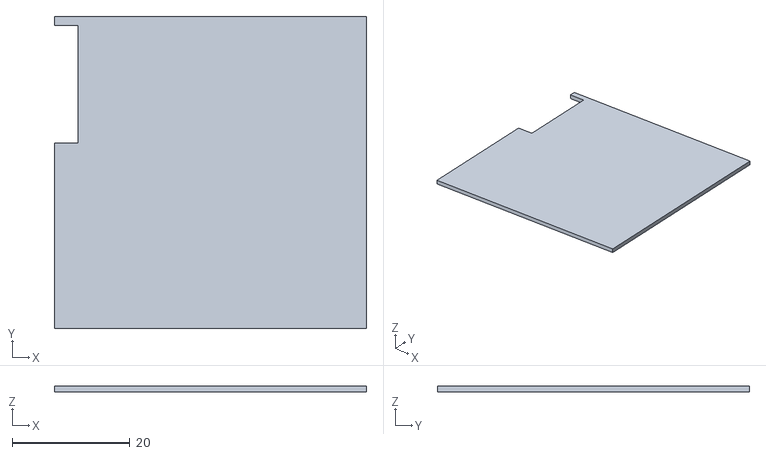
[picture p13: CAD file, 2026-10-28]
hardware/enclosure/board-plate.stl
53.0 x 53.0 x 1.00
