fred2u/VMC-Controller/docs/photos/12-montage-dans-boitier.jpg

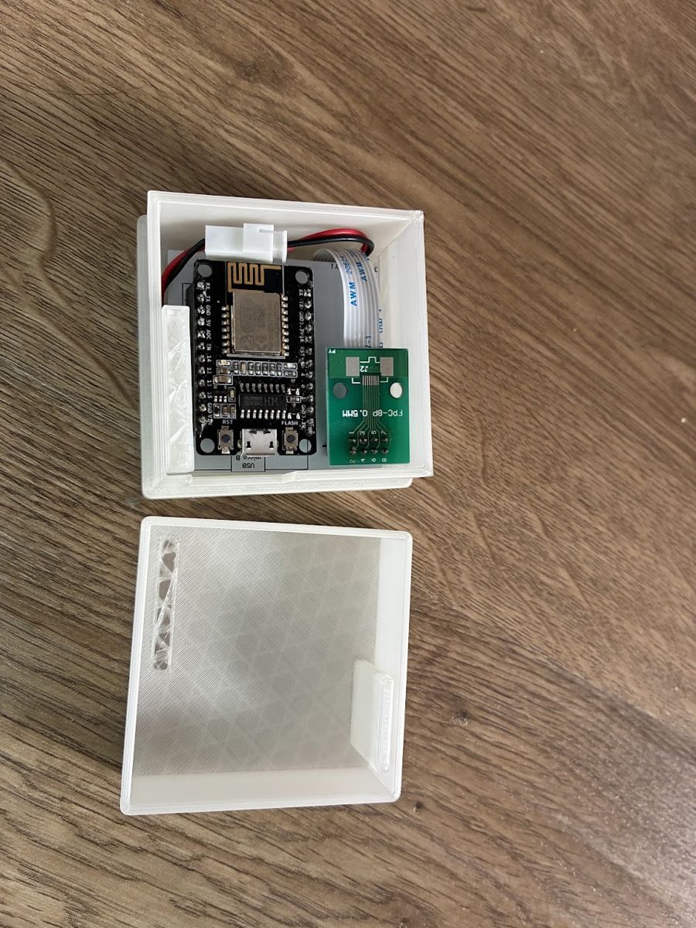
docs/photos/12-montage-dans-boitier.jpg
