fred2u/VMC-Controller/(commit log)

2021-02-01 Fix after test with real hardware
    [main.cpp]
2026-10-28 Document the project in the README
    Describe the hardware setup (Orcon MVS-15RH, 15RF remote driven by an
    ESP8266), wiring, build and flash steps, HTTP API, Home Assistant
    example, known limits and improvement ideas.
    Claude-Session: https://claude.ai/code/session_01GnBAxkY6TjmEnuYpvjJoGN
2026-10-28 Add remote photos and wiring details to the README
    Add photos of the disassembled Orcon 15RF remote, describe the FFC
    keypad connection and NodeMCU pin names, and confirm the 3 V supply
    and the rest_command Home Assistant setup.
    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
2026-10-28 Add 3D-printed enclosure STL files
    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
2026-10-28 Add smartphone screenshots and a Mermaid diagram to the README
    Replace the ASCII diagram in the Principe section with a Mermaid
    flowchart that GitHub renders, and add mobile screenshots of the web
    interface to the Utilisation section.
    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
2026-10-28 Document the custom PCB and fix the ESP board name
    Add the EasyEDA Gerber files and top and bottom renders of the 50x50 mm
    PCB that carries the ESP and the FFC breakout. The PCB footprint and
    platformio.ini show the board is a DOIT ESP-Mx DevKit (ESP8285), not a
    NodeMCU, so drop the NodeMCU pin names.
    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
2026-10-28 Add a roadmap of what the project is missing (#3)
    List pairing and remote reset from the UI, a factory reset button, a
    more compact hardware revision, Wi-Fi provisioning with a library, and
    the gaps found while documenting (OTA, MQTT, lost commands, UI fixes).
    Link it from the README.
    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
2026-10-28 Ajouter des tests unitaires et une CI (#4)
    * Add native unit tests for the firmware and a CI workflow
    src/main.cpp is compiled unchanged against fake Arduino, WiFi, LittleFS
    and ESP Async WebServer headers (test/mocks/). The fakes record GPIO
    writes and delays so the tests check button pulses, Max timers, the
    /mode answer and the web routes. Max being ignored in High mode is
    tested as current behaviour, not changed.
    CI runs the native tests and builds the ESP firmware.
    Claude-Session: https://claude.ai/code/session_01GnBAxmpmqcTr1xaPgy9536
    * Point lib_deps at the original ESPAsyncWebServer GitHub repo
    The PlatformIO registry no lon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
2026-10-28 Corriger les petits défauts de l'interface web et la passer en anglais (#5)
    * Corriger les petits défauts de l'interface web
    - style.css : `margin: 0 10px O O` (lettre O) devient `margin: 0 10px`
    - index.html : balise meta charset séparée du viewport, attributs href inutiles retirés
    - script.js : mode affiché dès l'ouverture, bouton du mode actif mis en évidence,
    textContent au lieu de innerHTML
    - « Current mode » devient « Last mode sent »
    - ROADMAP.md : points faits cochés
    Aucun changement du firmware (src/main.cpp intact).
    Claude-Session: https://claude.ai/code/session_01GnBAxk6JvUtwXH9JMNq58P
    * Passer toute l'inte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
2026-10-28 Translate the documentation into English (#7)
    * Translate the documentation into English
    README.md and ROADMAP.md are now in English, with the same content.
    Photo, PCB image and enclosure folder names are renamed to English
    (hardware/boitier -> hardware/enclosure) and the links follow.
    Code comments were already in English. No code change.
    Claude-Session: https://claude.ai/code/session_01GnBAxhL4aDX7EJ77J9LYYR
    * Give the enclosure STL files descriptive names
    Body2/3/4.stl become enclosure-bottom.stl, enclosure-lid.stl and
    board-plate.stl, matching the parts listed in the README.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
2026-10-28 Add a bill of materials and fix the keypad FFC pitch (#9)
    * Add a bill of materials and fix the keypad FFC pitch (1.0 mm)
    The photos show the FFC breakout's connector soldered on the 1.0 mm side;
    the 0.5MM silkscreen is the unused pad row on the other side.
    Claude-Session: https://claude.ai/code/session_01GnBAxjApG7gRTbRUQPDE9j
    * BOM: add the ESP-M2 board listing confirmed by fred
    Claude-Session: https://claude.ai/code/session_01GnBAxjApG7gRTbRUQPDE9j
    ---------
2026-10-28 Add a NodeMCU v3 test environment (#10)
    Move the shared ESP8266 settings to an [esp8266] section and add a
    nodemcuv2 environment that extends it. espmxdevkit stays the default
    and resolves to the same settings as before. CI builds both boards.
    The README gets a NodeMCU pin table and LED wiring for testing
    without the remote.
    Claude-Session: https://claude.ai/code/session_01GnBAxhM5brg7FrunC3KnmR
2026-10-28 Update the libraries and add updates over Wi-Fi (OTA) (#11)
    * Add a NodeMCU v3 test environment
    * Switch to the maintained async libraries and pin the platform
    The me-no-dev ESPAsyncTCP and ESPAsyncWebServer repos are archived.
    Use the ESP32Async forks from the PlatformIO registry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
2026-10-28 Pick the Wi-Fi network from a setup portal (ESPAsyncWiFiManager) (#12)
    * Pick the Wi-Fi network from a setup portal (ESPAsyncWiFiManager)
    When the ESP has no saved network or cannot reach it within 30 s, it
    opens the VMC-Setup access point with a captive portal for 3 minutes,
    built on the async web server already in use. The portal keeps retrying
    the saved network, so a router that boots slowly after a power cut is
    picked up as soon as it is back. include/wifi.h becomes optional: it
    holds the OTA password and an optional fallback network (WIFI_SSID,
    WIFI_PASSWORD) used only when nothing is saved yet.
    GPIOs are now set up before Wi-Fi, and the web routes are added after
    the portal, which cl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
2026-10-28 Windows commands in the README, OTA password for Wi-Fi uploads only (#13)
    the portal, which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
2026-10-28 Give the test board its own network name (vmc-test) (#14)
    The NodeMCU test build used the same hostname as the production board,
    so the router handed "vmc" to whichever board joined last and the
    production board dropped off http://vmc/ and Home Assistant. The
    hostname is now VMC_HOSTNAME, "vmc" by default and "vmc-test" for the
    nodemcuv2 environment (DHCP name and OTA mDNS name).
    Claude-Session: https://claude.ai/code/session_01GnBAxizGWQCDCmXDhgkxfk
2026-10-28 Show the firmware version from the Git tags (/version and web page) (#15)
    scripts/version.py builds git describe --tags --always --dirty into the
    firmware (project code only), with 'unknown' as fallback. The ESP prints it
    at boot, answers it on /version, and the web page shows it in the footer.
    CI checks out the full history so the tags are there. README: Releases
    section with the tagging steps.
    Claude-Session: https://claude.ai/code/session_01GnBAxkqZShff6jW1XcCp1A
2026-10-28 Add _ota environments that always upload over Wi-Fi (#16)
    PlatformIO only switches to espota for an IP address or a .local name;
    any other --upload-port (a router DNS name like vmc-test.lan) went to
    esptool as a serial port. espmxdevkit_ota and nodemcuv2_ota force
    upload_protocol = espota, default to vmc.local / vmc-test.local, and
    still accept --upload-port. scripts/ota_auth.py keeps adding the
    password since the uploader is espota.py.
    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
2026-10-28 Show the IP address in the web page and redesign it for smartphones (#17)
    - New GET /info route (JSON): version, hostname, IP address and Wi-Fi
    signal (RSSI). /version is unchanged.
    - Web interface rewritten without Milligram (11 KB instead of 13 KB):
    light and dark themes, big "last mode sent" card with a fan that turns
    faster with the speed, buttons grouped by Speed / Program / Max,
    Online/Offline badge after two failed refreshes, Max buttons greyed
    out in High (the firmware ignores them there), board details at the
    bottom. Falls back to /version on older firmware.
    - Button routes are unchanged (Home Assistant).
    - Unit test for /info, mocks for IPAddress::toString and WiFi.RSSI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
2026-10-28 Send commands without blocking, keep the last one, answer the mode (#18)
    - loop() no longer calls delay(): a millis() state machine presses and
    releases the buttons, so the web server and OTA keep answering.
    - A command received while another one is being sent waits for it to
    finish. A newer one replaces it: only the last command counts.
    - The commands are a table; the web server and loop() share small
    volatile numbers instead of String.
    - The Max timer uses millis() instead of time(0) and survives the
    49-day wraparound.
    - Command routes answer the mode they set (text/plain). Max in High is
    refused with 409 instead of a silent 200. URLs are unchanged.
    - Tests: fake millis() (32 bit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
2026-10-28 Add remote pairing, remote reset and a maintenance page (#19)
    * Send commands without blocking, keep the last one, answer the mode
    refused with 409 instead of a sil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
2026-10-29 Add optional passwords for the web interface and VMC-Setup, and a web update (#20)
    refused with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
2026-10-29 Add optional MQTT with Home Assistant discovery (#21)
    refused with 409 instead of a silent 200.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
2026-10-29 Bring the documentation up to date with v1.2 and clean up leftovers (#22)
    - README: optional authentication in the warning, MQTT in the diagram
    and software table, interface size (~20 KB), firmware sizes with
    options, VMC-Setup password, Forget Wi-Fi instead of erasing the
    flash, mocks list, /info "update" field, full folder layout, links
    to the changelog.
    - ROADMAP: what remains first (reset button, compact PCB, circuit
    diagram, boot pins, displayed state, pairing time), then what was
    done in v1.0, v1.1 and v1.2.
    - New CHANGELOG.md for v1.0, v1.1 and v1.2.
    - New screenshots of the current interface, plus the Maintenance page.
    - include/README, test/README, platformio.ini and mai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
